huskyroboticsteam/Electronics-2017-18/README.md

# Electronics-2017-18

This is the 2017-18 Husky Robotics repository for electronics board designs and everything else electronics!
