huskyroboticsteam/Electronics-2017-18/EagleBoards/README.txt

Folder for the HRT Eagle library, Eagle Boards
