huskyroboticsteam/Electronics-2017-18/BrushedMotorBoard/BOM/BoM.xlsx

Manufacturer Part Number | Manufacturer | Digi-Key Part Number | Customer Reference | Reference Designator | Packaging | Part Status | Quantity | Unit Price | Extended Price | Quantity Available | Mfg Std Lead Time | Description | RoHS Status | Lead Free Status | REACH Status
STM32F334R8T6 | STMicroelectronics | 497-14955-ND |  |  | Tray | Active | 1 | 4.97 | $4.97 | 1897 | 10 Weeks | IC MCU 32BIT 64KB FLASH 64LQFP | RoHS Compliant | Lead free | Not Available
61300311121 | Wurth Electronics Inc. | 732-5316-ND |  |  | Bag | Active | 1 | 0.13 | $0.13 | 233027 | 14 Weeks | CONN HEADER 3 POS 2.54 | RoHS Compliant | Lead free | REACH Unaffected
SPC02SYAN | Sullins Connector Solutions | S9001-ND |  |  | Bulk | Active | 1 | 0.1 | $0.10 | 701455 | 4 Weeks | CONN JUMPER SHORTING GOLD FLASH | RoHS Compliant | Lead free | REACH Unaffected
ECS-110.5-S-4X | ECS Inc. | X1064-ND |  |  | Bulk | Active | 1 | 0.74 | $0.74 | 2156 | 9 Weeks | CRYSTAL 11.0592MHZ SERIES T/H | RoHS Compliant | Lead free | Not Available
RC1206JR-071M8L | Yageo | 311-1.8MERCT-ND |  |  | Cut Tape (CT) | Active | 1 | 0.1 | $0.10 | 0 | 29 Weeks | RES SMD 1.8M OHM 5% 1/4W 1206 | RoHS Compliant | Lead free | REACH Unaffected
CC1206JRNPO9BN180 | Yageo | 311-1152-1-ND |  |  | Cut Tape (CT) | Active | 2 | 0.3 | $0.60 | 34678 | 36 Weeks | CAP CER 18PF 50V C0G/NPO 1206 | RoHS Compliant | Lead free | REACH Unaffected
CC1206MRY5V9BB104 | Yageo | 311-4504-1-ND |  |  | Cut Tape (CT) | Active | 4 | 0.42 | $1.68 | 7894 | 36 Weeks | CAP CER 0.1UF 50V Y5V 1206 | RoHS Compliant | Lead free | REACH Unaffected
CC1206KKX7RCBB103 | Yageo | 311-1500-1-ND |  |  | Cut Tape (CT) | Active | 1 | 0.68 | $0.68 | 30000 | Not Available | CAP CER 10000PF 1KV X7R 1206 | RoHS Compliant | Lead free | REACH Unaffected
TXB0102DCUR | Texas Instruments | 296-22862-1-ND |  |  | Cut Tape (CT) | Active | 1 | 0.92 | $0.92 | 53958 | 12 Weeks | IC TRNSLTR BIDIRECTIONAL US8 | RoHS Compliant | Lead free | REACH Unaffected
ZX62D1-B-5PA(30) | Hirose Electric Co Ltd | H126316CT-ND |  |  | Cut Tape (CT) | Active | 2 | 0.77 | $1.54 | 3000 | 12 Weeks | CONN RCPT USB MICRO B 2.0 SMD RA | RoHS Compliant | Lead free | Not Available
0022232041 | Molex, LLC | WM4202-ND |  |  | Bulk | Active | 2 | 0.28 | $0.56 | 51523 | 7 Weeks | CONN HEADER 4POS .100 VERT TIN | RoHS Compliant | Lead free | REACH Unaffected
