huskyroboticsteam/Electronics-2017-18/Science/CAD Parts/MOLEX/MOLEX_22-23-2041.stl

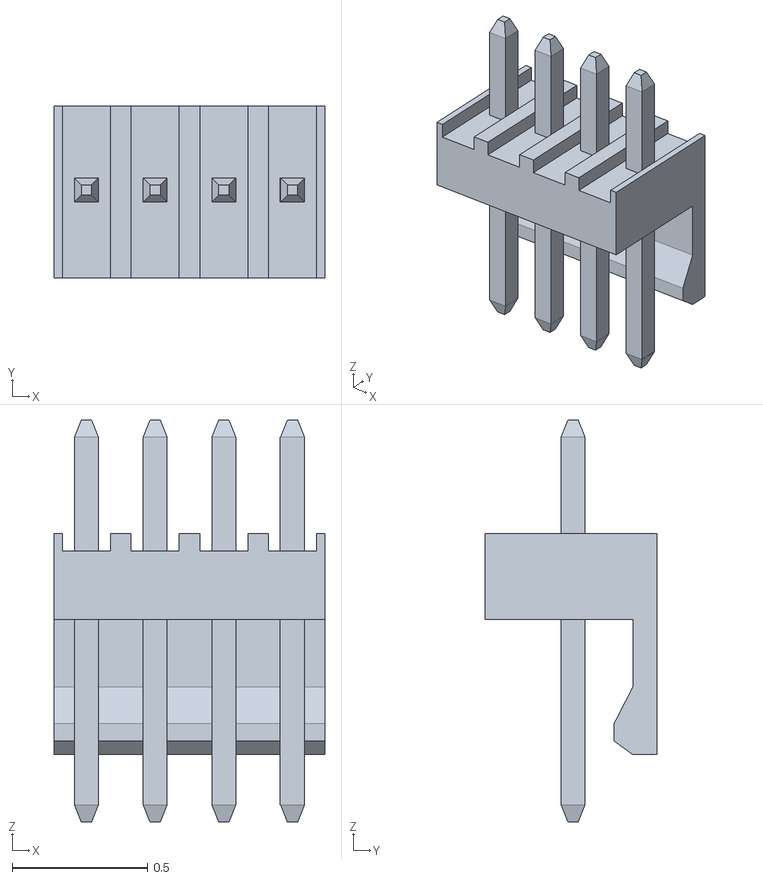
[picture p1: CAD file, 2018-01-22]
Science/CAD Parts/MOLEX/MOLEX_22-23-2041.stl
1.00 x 0.635 x 1.49
