huskyroboticsteam/Electronics-2017-18/Science/CAD Parts/PACKAGES/8SIOC.stp

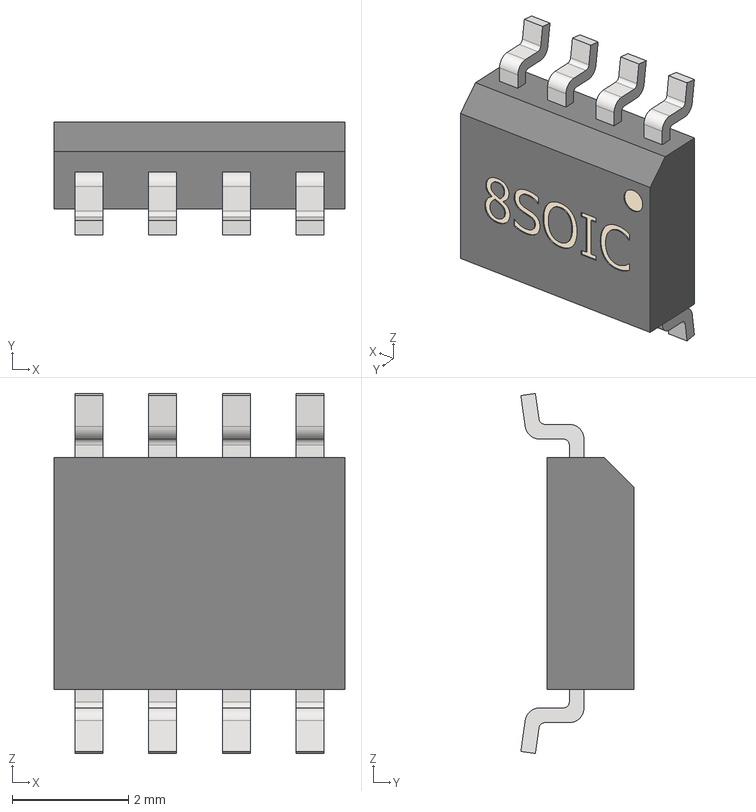
[picture p2: CAD file, 2018-01-22]
Science/CAD Parts/PACKAGES/8SIOC.stp
5.00 x 1.95 x 6.20 mm
8SOIC_BODY
8SOIC_PIN x 8
