huskyroboticsteam/Electronics-2017-18/Science/CAD Parts/MOLEX/MOLEX_22-23-2031.stl

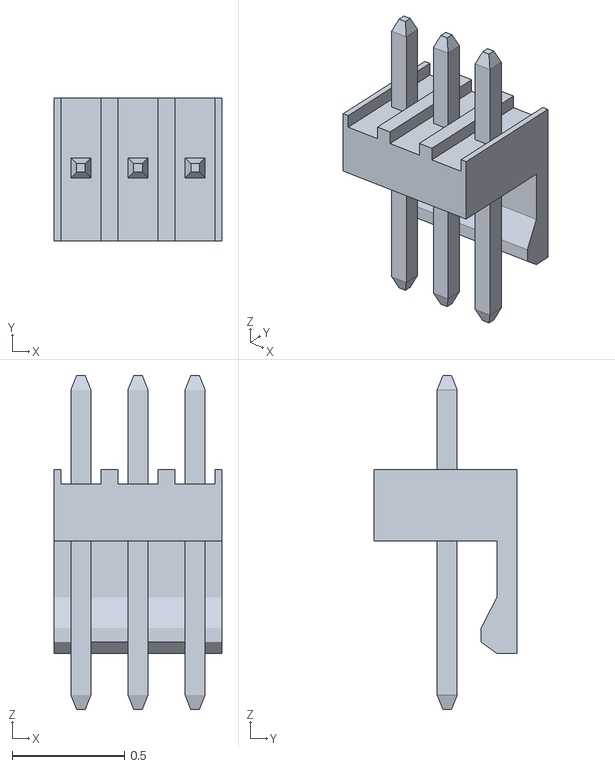
[picture p3: CAD file, 2018-01-22]
Science/CAD Parts/MOLEX/MOLEX_22-23-2031.stl
0.747 x 0.635 x 1.49
