huskyroboticsteam/Electronics-2017-18/BrushedMotorBoard/Models/022232041.stp

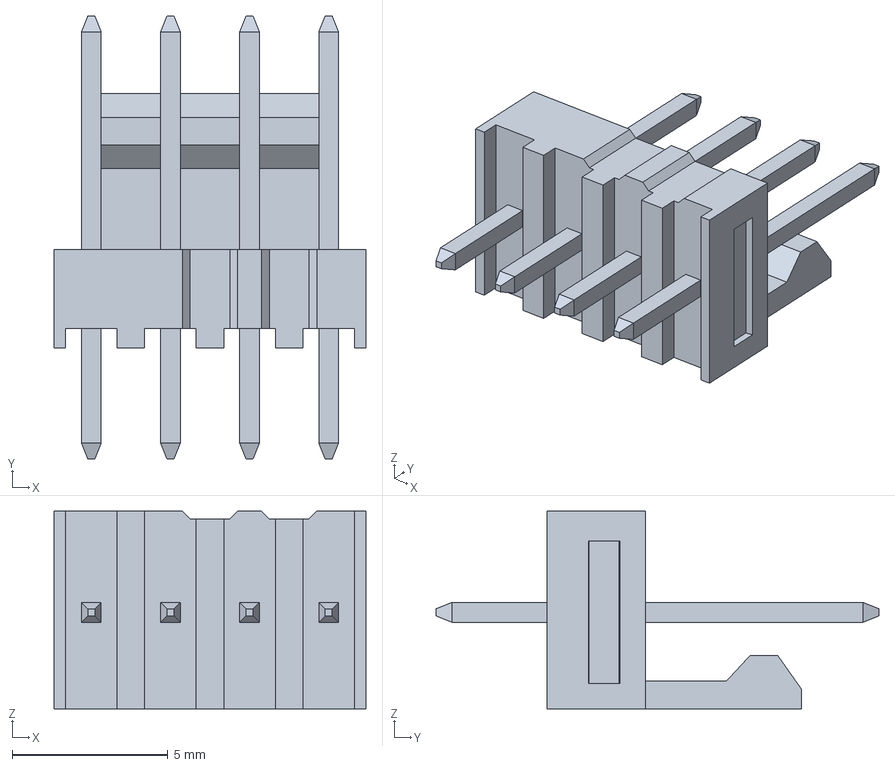
[picture p4: CAD file, 2018-10-06]
BrushedMotorBoard/Models/022232041.stp
10.0 x 14.2 x 6.35 mm
