huskyroboticsteam/Electronics-2017-18/(list of files, cad)

Other CAD files:
Science/CAD Parts/MOLEX/MOLEX_22-23-2031.ipt
Science/CAD Parts/MOLEX/MOLEX_22-23-2041.ipt
Science/CAD Parts/PACKAGES/8SIOC.iam
Science/CAD Parts/PACKAGES/8SIOC.stl
Science/CAD Parts/PACKAGES/8SOIC_BODY.ipt
Science/CAD Parts/PACKAGES/8SOIC_PIN.ipt
