huskyroboticsteam/Electronics-2017-18/(list of files, drawings)

Other design files:
BrushedMotorBoard/BrushedMotorBoard.PrjPcb
BrushedMotorBoard/HRTAltiumLib.SchLib
BrushedMotorBoard/HRTAltiumPcbLib.PcbLib
BrushedMotorBoard/Microcontroller.SchDoc
BrushedMotorBoard/Peripherals.SchDoc
BrushedMotorBoard/Power.SchDoc
