huskyroboticsteam/Electronics-2017-18/Science/Designs/Main Board/Main Board.kicad_pcb

## KiCad design Science/Designs/Main Board/Main Board.kicad_pcb (2018-01-23)

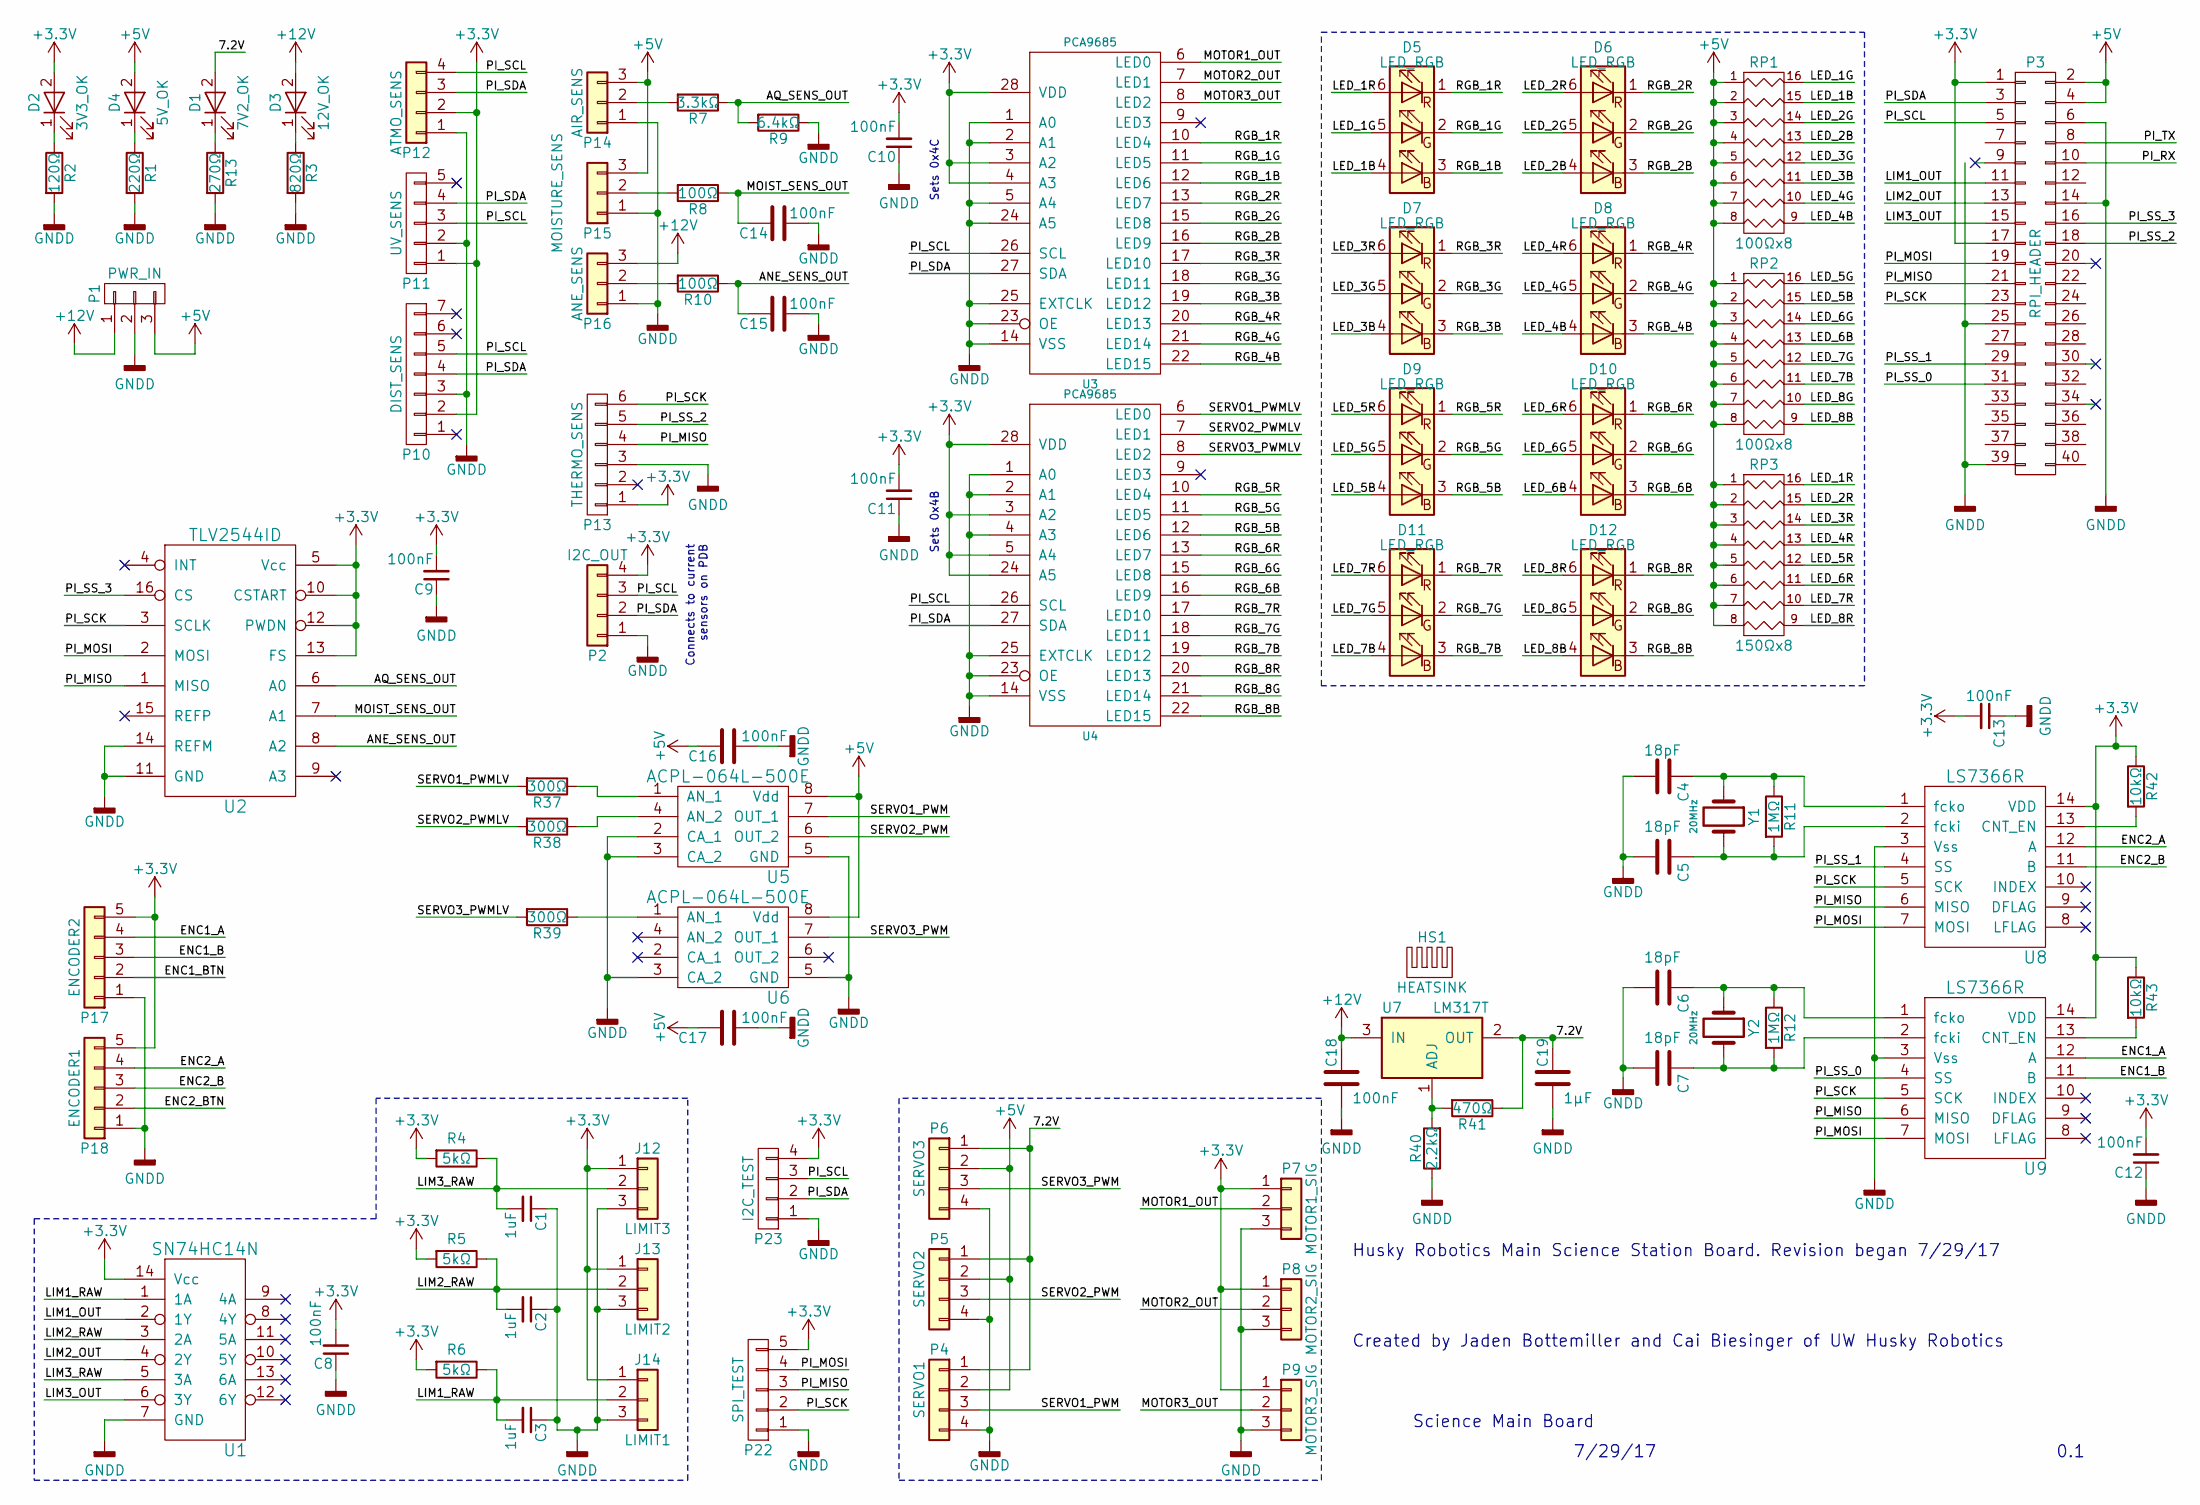
[picture p5: schematic Main Board.sch]

Parts:
C1, C2, C3: 1uF; C_1206_HandSoldering
C4, C5, C6, C7: 18pF; C_1206_HandSoldering
C8, C9, C10, C11, C12, C13, C14, C15, C16, C17, C18: 100nF; C_1206_HandSoldering
C19: 1µF; C_1206_HandSoldering
D1: 7V2_OK; LED_D5.0mm
D2: 3V3_OK; LED_D5.0mm
D3: 12V_OK; LED_D5.0mm
D4: 5V_OK; LED_D5.0mm
D5, D6, D7, D8, D9, D10, D11, D12: LED_RGB; SLV6A-FKB
HS1: HEATSINK; AAVID_531202B02500G
J12: LIMIT3; MOLEX_22-23-2031
J13: LIMIT2; MOLEX_22-23-2031
J14: LIMIT1; MOLEX_22-23-2031
P1: PWR_IN; PHOENIX_1792232
P2: I2C_OUT; MOLEX_22-23-2041
P3: RPI_HEADER; RPi-3B
P4: SERVO1; MOLEX_22-23-2041
P5: SERVO2; MOLEX_22-23-2041
P6: SERVO3; MOLEX_22-23-2041
P7: MOTOR1_SIG; MOLEX_22-23-2031
P8: MOTOR2_SIG; MOLEX_22-23-2031
P9: MOTOR3_SIG; MOLEX_22-23-2031
P10: DIST_SENS; MOLEX_22-23-2071
P11: UV_SENS; MOLEX_22-23-2051
P12: ATMO_SENS; MOLEX_22-23-2041
P13: THERMO_SENS; MOLEX_22-23-2061
P14: AIR_SENS; MOLEX_22-23-2031
P15: MOISTURE_SENS; MOLEX_22-23-2031
P16: ANE_SENS; MOLEX_22-23-2031
P17: ENCODER2; MOLEX_22-23-2051
P18: ENCODER1; MOLEX_22-23-2051
P22: SPI_TEST; Pin_Header_Straight_1x05_Pitch2.54mm
P23: I2C_TEST; Pin_Header_Straight_1x04_Pitch2.54mm
R1: 220Ω; R_1206_HandSoldering
R2: 120Ω; R_1206_HandSoldering
R3: 820Ω; R_1206_HandSoldering
R4, R5, R6: 5kΩ; R_1206_HandSoldering
R7: 3.3kΩ; R_1206_HandSoldering
R8, R10: 100Ω; R_1206_HandSoldering
R9: 6.4kΩ; R_1206_HandSoldering
R11, R12: 1MΩ; R_1206_HandSoldering
R13: 270Ω; R_1206_HandSoldering
R37, R38, R39: 300Ω; R_1206_HandSoldering
R40: 2.2kΩ; R_1206_HandSoldering
R41: 470Ω; R_1206_HandSoldering
R42, R43: 10kΩ; R_1206_HandSoldering
RP1, RP2: 100Ωx8; SOIC-16_3.9x9.9mm_Pitch1.27mm
RP3: 150Ωx8; SOIC-16_3.9x9.9mm_Pitch1.27mm
U1: SN74HC14N; SOIC-14_3.9x8.7mm_Pitch1.27mm
U2: TLV2544ID; SOIC-16_3.9x9.9mm_Pitch1.27mm
U3, U4: PCA9685; TSSOP-28_4.4x9.7mm_Pitch0.65mm
U5, U6: ACPL-064L-500E; SOIC-8_3.9x4.9mm_Pitch1.27mm
U7: LM317T; TO-220-3_Vertical
U8, U9: LS7366R; SOIC-14_3.9x8.7mm_Pitch1.27mm
Y1, Y2: 20MHz; HC-49USX

Connections:
+3V3: C8.2, C9.2, C10.2, C11.2, C12.2, C13.2, D2.2 (A), J12.1, J13.1, J14.1, P2.4, P3.1, P3.17, P7.1, P8.1, P9.1, P10.2, P11.1, P12.2, P13.1, P17.5, P18.5, P22.5, P23.4, R4.2, R5.2, R6.2, R42.1, R43.1, U1.14 (Vcc), U2.5 (Vcc), U2.10 (CSTART), U2.12 (PWDN), U2.13 (FS), U3.3 (A2), U3.4 (A3), U3.28 (VDD), U4.3 (A2), U4.5 (A4), U4.24 (A5), U4.28 (VDD), U8.14 (VDD), U9.14 (VDD)
+5V: C16.1, C17.1, D4.2 (A), P1.3, P3.2, P3.4, P4.2, P5.2, P6.2, P14.3, P15.3, RP1.1, RP1.2, RP1.3, RP1.4, RP1.5, RP1.6, RP1.7, RP1.8, RP2.1, RP2.2, RP2.3, RP2.4, RP2.5, RP2.6, RP2.7, RP2.8, RP3.1, RP3.2, RP3.3, RP3.4, RP3.5, RP3.6, RP3.7, RP3.8, U5.8 (Vdd), U6.8 (Vdd)
+12V: C18.1, D3.2 (A), P1.1, P16.3, U7.3 (IN)
/7.2V: C19.1, D1.2 (A), P4.1, P5.1, P6.1, R41.1, U7.2 (OUT)
/ANE_SENS_OUT: C15.2, R10.1, U2.8 (A2)
/AQ_SENS_OUT: R7.1, R9.2, U2.6 (A0)
/ENC1_A: P17.4, U9.12 (A)
/ENC1_B: P17.3, U9.11 (B)
/ENC1_BTN: P17.2
/ENC2_A: P18.4, U8.12 (A)
/ENC2_B: P18.3, U8.11 (B)
/ENC2_BTN: P18.2
/LED_1B: D5.4 (BA), RP1.15 (R2)
/LED_1G: D5.5 (GA), RP1.16 (R1)
/LED_1R: D5.6 (RA), RP3.16 (R1)
/LED_2B: D6.4 (BA), RP1.13 (R4)
/LED_2G: D6.5 (GA), RP1.14 (R3)
/LED_2R: D6.6 (RA), RP3.15 (R2)
/LED_3B: D7.4 (BA), RP1.11 (R6)
/LED_3G: D7.5 (GA), RP1.12 (R5)
/LED_3R: D7.6 (RA), RP3.14 (R3)
/LED_4B: D8.4 (BA), RP1.9 (R8)
/LED_4G: D8.5 (GA), RP1.10 (R7)
/LED_4R: D8.6 (RA), RP3.13 (R4)
/LED_5B: D9.4 (BA), RP2.15 (R2)
/LED_5G: D9.5 (GA), RP2.16 (R1)
/LED_5R: D9.6 (RA), RP3.12 (R5)
/LED_6B: D10.4 (BA), RP2.13 (R4)
/LED_6G: D10.5 (GA), RP2.14 (R3)
/LED_6R: D10.6 (RA), RP3.11 (R6)
/LED_7B: D11.4 (BA), RP2.11 (R6)
/LED_7G: D11.5 (GA), RP2.12 (R5)
/LED_7R: D11.6 (RA), RP3.10 (R7)
/LED_8B: D12.4 (BA), RP2.9 (R8)
/LED_8G: D12.5 (GA), RP2.10 (R7)
/LED_8R: D12.6 (RA), RP3.9 (R8)
/LIM1_OUT: P3.11, U1.2 (1Y)
/LIM1_RAW: C3.2, J14.2, R6.1, U1.1 (1A)
/LIM2_OUT: P3.13, U1.4 (2Y)
/LIM2_RAW: C2.2, J13.2, R5.1, U1.3 (2A)
/LIM3_OUT: P3.15, U1.6 (3Y)
/LIM3_RAW: C1.2, J12.2, R4.1, U1.5 (3A)
/MOIST_SENS_OUT: C14.2, R8.1, U2.7 (A1)
/MOTOR1_OUT: P7.2, U3.6 (LED0)
/MOTOR2_OUT: P8.2, U3.7 (LED1)
/MOTOR3_OUT: P9.2, U3.8 (LED2)
/PI_MISO: P3.21, P13.4, P22.3, U2.1 (MISO), U8.6 (MISO), U9.6 (MISO)
/PI_MOSI: P3.19, P22.4, U2.2 (MOSI), U8.7 (MOSI), U9.7 (MOSI)
/PI_RX: P3.10
/PI_SCK: P3.23, P13.6, P22.2, U2.3 (SCLK), U8.5 (SCK), U9.5 (SCK)
/PI_SCL: P2.3, P3.5, P10.5, P11.3, P12.4, P23.3, U3.26 (SCL), U4.26 (SCL)
/PI_SDA: P2.2, P3.3, P10.4, P11.4, P12.3, P23.2, U3.27 (SDA), U4.27 (SDA)
/PI_SS_0: P3.31, U9.4 (SS)
/PI_SS_1: P3.29, U8.4 (SS)
/PI_SS_2: P3.18, P13.5
/PI_SS_3: P3.16, U2.16 (CS)
/PI_TX: P3.8
/RGB_1B: D5.3 (BK), U3.12 (LED6)
/RGB_1G: D5.2 (GK), U3.11 (LED5)
/RGB_1R: D5.1 (RK), U3.10 (LED4)
/RGB_2B: D6.3 (BK), U3.16 (LED9)
/RGB_2G: D6.2 (GK), U3.15 (LED8)
/RGB_2R: D6.1 (RK), U3.13 (LED7)
/RGB_3B: D7.3 (BK), U3.19 (LED12)
/RGB_3G: D7.2 (GK), U3.18 (LED11)
/RGB_3R: D7.1 (RK), U3.17 (LED10)
/RGB_4B: D8.3 (BK), U3.22 (LED15)
/RGB_4G: D8.2 (GK), U3.21 (LED14)
/RGB_4R: D8.1 (RK), U3.20 (LED13)
/RGB_5B: D9.3 (BK), U4.12 (LED6)
/RGB_5G: D9.2 (GK), U4.11 (LED5)
/RGB_5R: D9.1 (RK), U4.10 (LED4)
/RGB_6B: D10.3 (BK), U4.16 (LED9)
/RGB_6G: D10.2 (GK), U4.15 (LED8)
/RGB_6R: D10.1 (RK), U4.13 (LED7)
/RGB_7B: D11.3 (BK), U4.19 (LED12)
/RGB_7G: D11.2 (GK), U4.18 (LED11)
/RGB_7R: D11.1 (RK), U4.17 (LED10)
/RGB_8B: D12.3 (BK), U4.22 (LED15)
/RGB_8G: D12.2 (GK), U4.21 (LED14)
/RGB_8R: D12.1 (RK), U4.20 (LED13)
/SERVO1_PWM: P4.3, U5.7 (OUT_1)
/SERVO1_PWMLV: R37.2, U4.6 (LED0)
/SERVO2_PWM: P5.3, U5.6 (OUT_2)
/SERVO2_PWMLV: R38.2, U4.7 (LED1)
/SERVO3_PWM: P6.3, U6.7 (OUT_1)
/SERVO3_PWMLV: R39.2, U4.8 (LED2)
GNDD: C1.1, C2.1, C3.1, C4.2, C5.2, C6.2, C7.2, C8.1, C9.1, C10.1, C11.1, C12.1, C13.1, C14.1, C15.1, C16.2, C17.2, C18.2, C19.2, J12.3, J13.3, J14.3, P1.2, P2.1, P3.6, P3.14, P3.25, P3.39, P4.4, P5.4, P6.4, P7.3, P8.3, P9.3, P10.3, P11.2, P12.1, P13.3, P14.1, P15.1, P16.1, P17.1, P18.1, P22.1, P23.1, R1.2, R2.2, R3.2, R9.1, R13.2, R40.1, U1.7 (GND), U2.11 (GND), U2.14 (REFM), U3.1 (A0), U3.2 (A1), U3.5 (A4), U3.14 (VSS), U3.23 (OE), U3.24 (A5), U3.25 (EXTCLK), U4.1 (A0), U4.2 (A1), U4.4 (A3), U4.14 (VSS), U4.23 (OE), U4.25 (EXTCLK), U5.2 (CA_1), U5.3 (CA_2), U5.5 (GND), U6.3 (CA_2), U6.5 (GND), U8.3 (Vss), U9.3 (Vss)
unnamed: C4.1, R11.1, U8.1 (fcko), Y1.1
unnamed: C5.1, R11.2, U8.2 (fcki), Y1.2
unnamed: C6.1, R12.1, U9.1 (fcko), Y2.1
unnamed: C7.1, R12.2, U9.2 (fcki), Y2.2
unnamed: D1.1 (K), R13.1
unnamed: D2.1 (K), R2.1
unnamed: D3.1 (K), R3.1
unnamed: D4.1 (K), R1.1
unnamed: P14.2, R7.2
unnamed: P15.2, R8.2
unnamed: P16.2, R10.2
unnamed: R37.1, U5.1 (AN_1)
unnamed: R38.1, U5.4 (AN_2)
unnamed: R39.1, U6.1 (AN_1)
unnamed: R40.2, R41.2, U7.1 (ADJ)
unnamed: R42.2, U8.13 (CNT_EN)
unnamed: R43.2, U9.13 (CNT_EN)

Notes on the sheet:
Husky Robotics Main Science Station Board. Revision began 7/29/17
Science Main Board
0.1
7/29/17
Created by Jaden Bottemiller and Cai Biesinger of UW Husky Robotics
Sets 0x4B
Sets 0x4C
Connects to current sensors on PDB

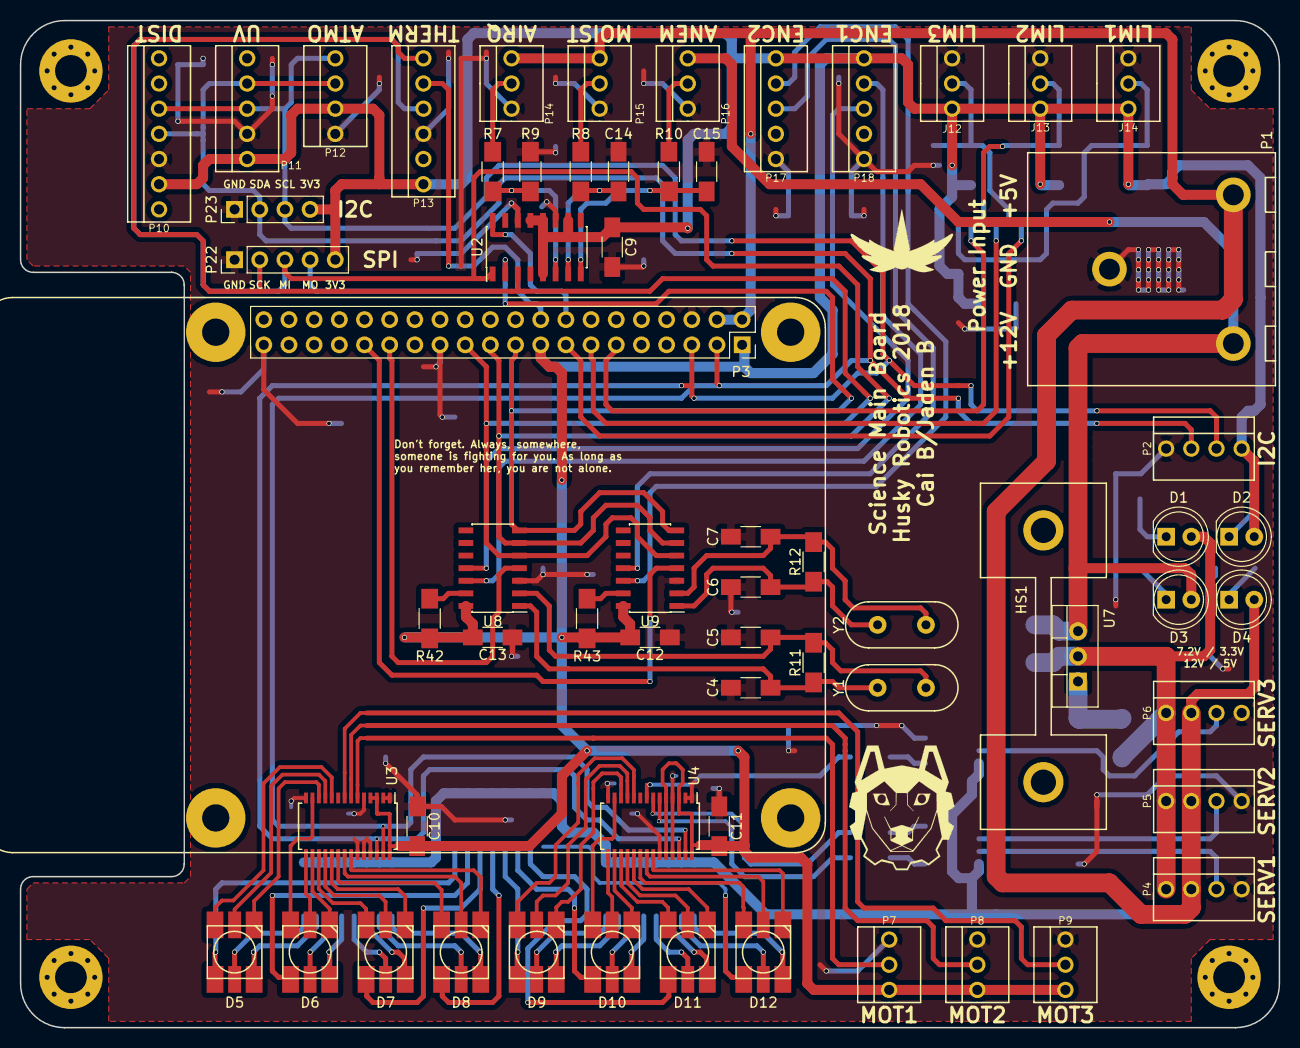
[picture p6: board Main Board.kicad_pcb from above]

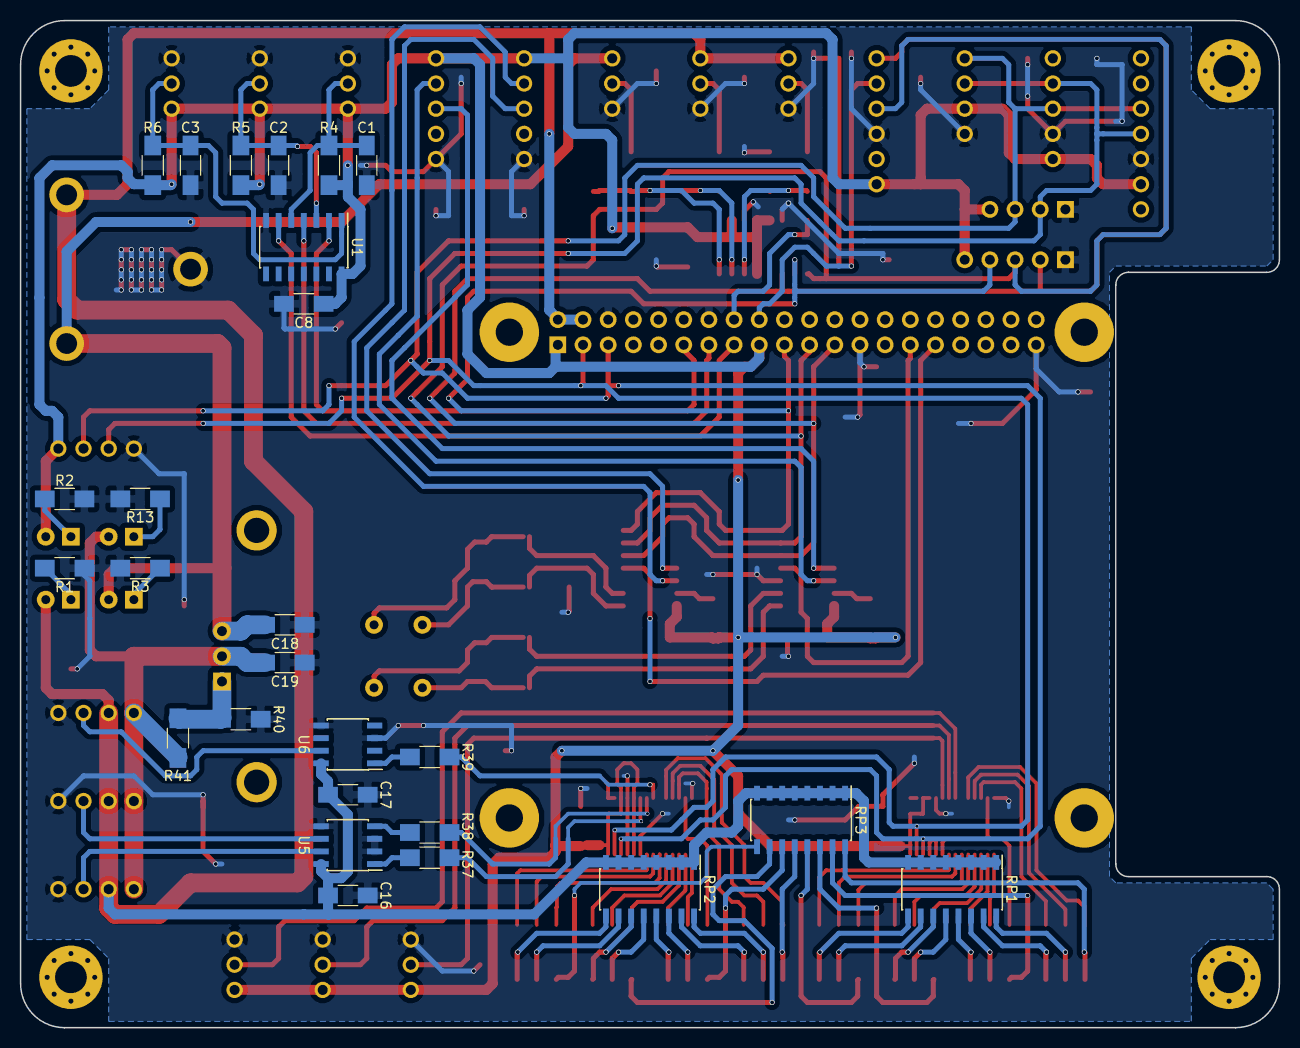
[picture p7: board Main Board.kicad_pcb from below]

Board: 2 copper layers, 127.0 x 101.6 mm, 89 parts (26 on the bottom side), 101 nets.
