huskyroboticsteam/Electronics-2017-18/Science/Designs/Power Board/Power Board.kicad_pcb

## KiCad design Science/Designs/Power Board/Power Board.kicad_pcb (2018-01-23)

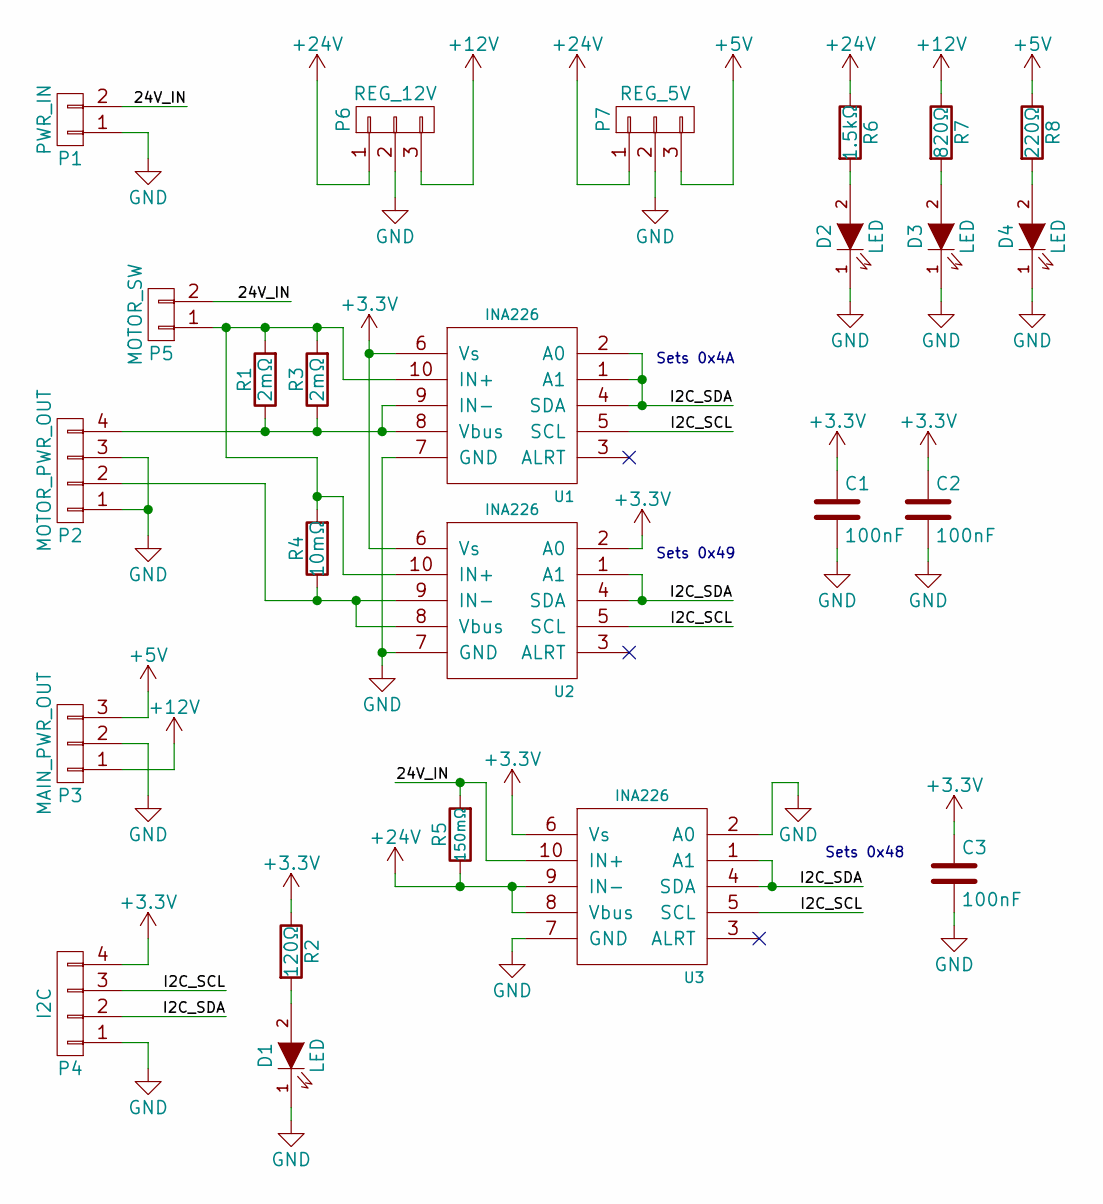
[picture p8: schematic Power Board.sch]

Parts:
C1, C2, C3: 100nF; C_1206_HandSoldering
D1, D2, D3, D4: LED; LED_D5.0mm
P1: PWR_IN; PHOENIX_1792229
P2: MOTOR_PWR_OUT; PHOENIX_1792245
P3: MAIN_PWR_OUT; PHOENIX_1792232
P4: I2C; MOLEX_22-23-2041
P5: MOTOR_SW; PHOENIX_1792229
P6: REG_12V; PHOENIX_1792232
P7: REG_5V; PHOENIX_1792232
R1, R3: 2mΩ; 2526W
R2: 120Ω; R_1206_HandSoldering
R4: 10mΩ; 2827W
R5: 150mΩ; R_Axial_Power_L25.0mm_W6.4mm_P30.48mm
R6: 1.5kΩ; R_1206_HandSoldering
R7: 820Ω; R_1206_HandSoldering
R8: 220Ω; R_1206_HandSoldering
U1, U2, U3: INA226; MSOP-10_3x3mm_Pitch0.5mm

Connections:
+3V3: C1.1, C2.1, C3.1, P4.4, R2.1, U1.6 (Vs), U2.2 (A0), U2.6 (Vs), U3.6 (Vs)
+5V: P3.3, P7.3, R8.1
+12V: P3.1, P6.3, R7.1
+24V: P6.1, P7.1, R5.1, R6.1, U3.8 (Vbus), U3.9 (IN-)
/24V_IN: P1.2, P5.2, R5.2, U3.10 (IN+)
/I2C_SCL: P4.3, U1.5 (SCL), U2.5 (SCL), U3.5 (SCL)
/I2C_SDA: P4.2, U1.1 (A1), U1.2 (A0), U1.4 (SDA), U2.1 (A1), U2.4 (SDA), U3.1 (A1), U3.4 (SDA)
GND: C1.2, C2.2, C3.2, D1.1 (K), D2.1 (K), D3.1 (K), D4.1 (K), P1.1, P2.1, P2.3, P3.2, P4.1, P6.2, P7.2, U1.7 (GND), U2.7 (GND), U3.2 (A0), U3.7 (GND)
unnamed: D1.2 (A), R2.2
unnamed: D2.2 (A), R6.2
unnamed: D3.2 (A), R7.2
unnamed: D4.2 (A), R8.2
unnamed: P2.2, R4.1, U2.8 (Vbus), U2.9 (IN-)
unnamed: P2.4, R1.1, R3.1, U1.8 (Vbus), U1.9 (IN-)
unnamed: P5.1, R1.2, R3.2, R4.2, U1.10 (IN+), U2.10 (IN+)

Notes on the sheet:
Sets 0x4A
Sets 0x49
Sets 0x48

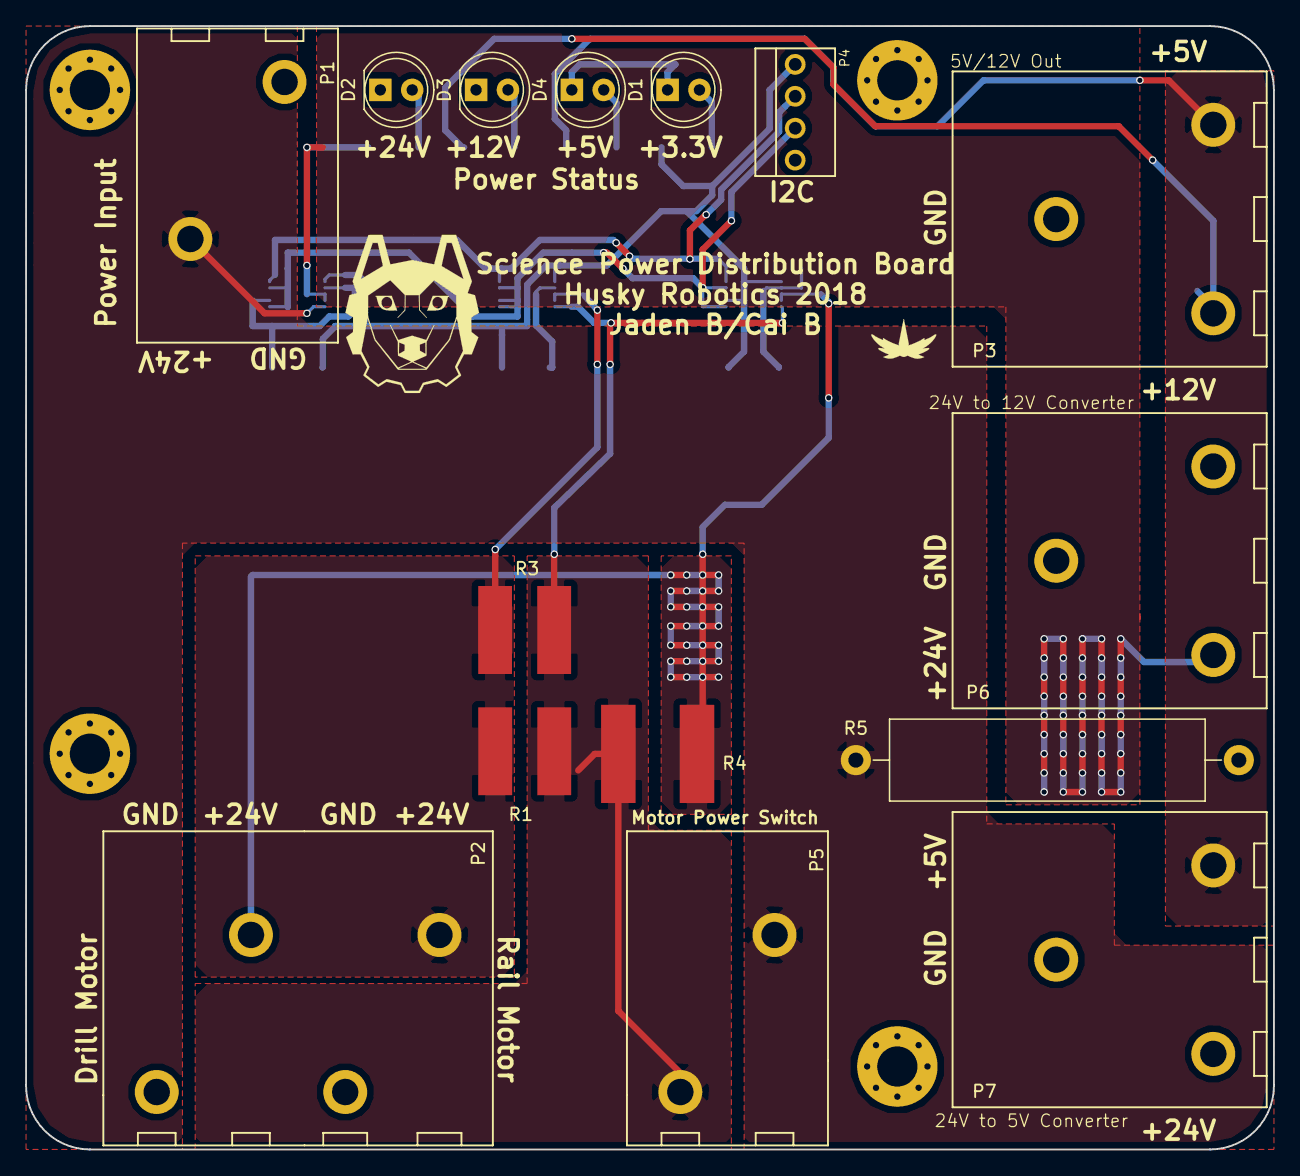
[picture p9: board Power Board.kicad_pcb from above]

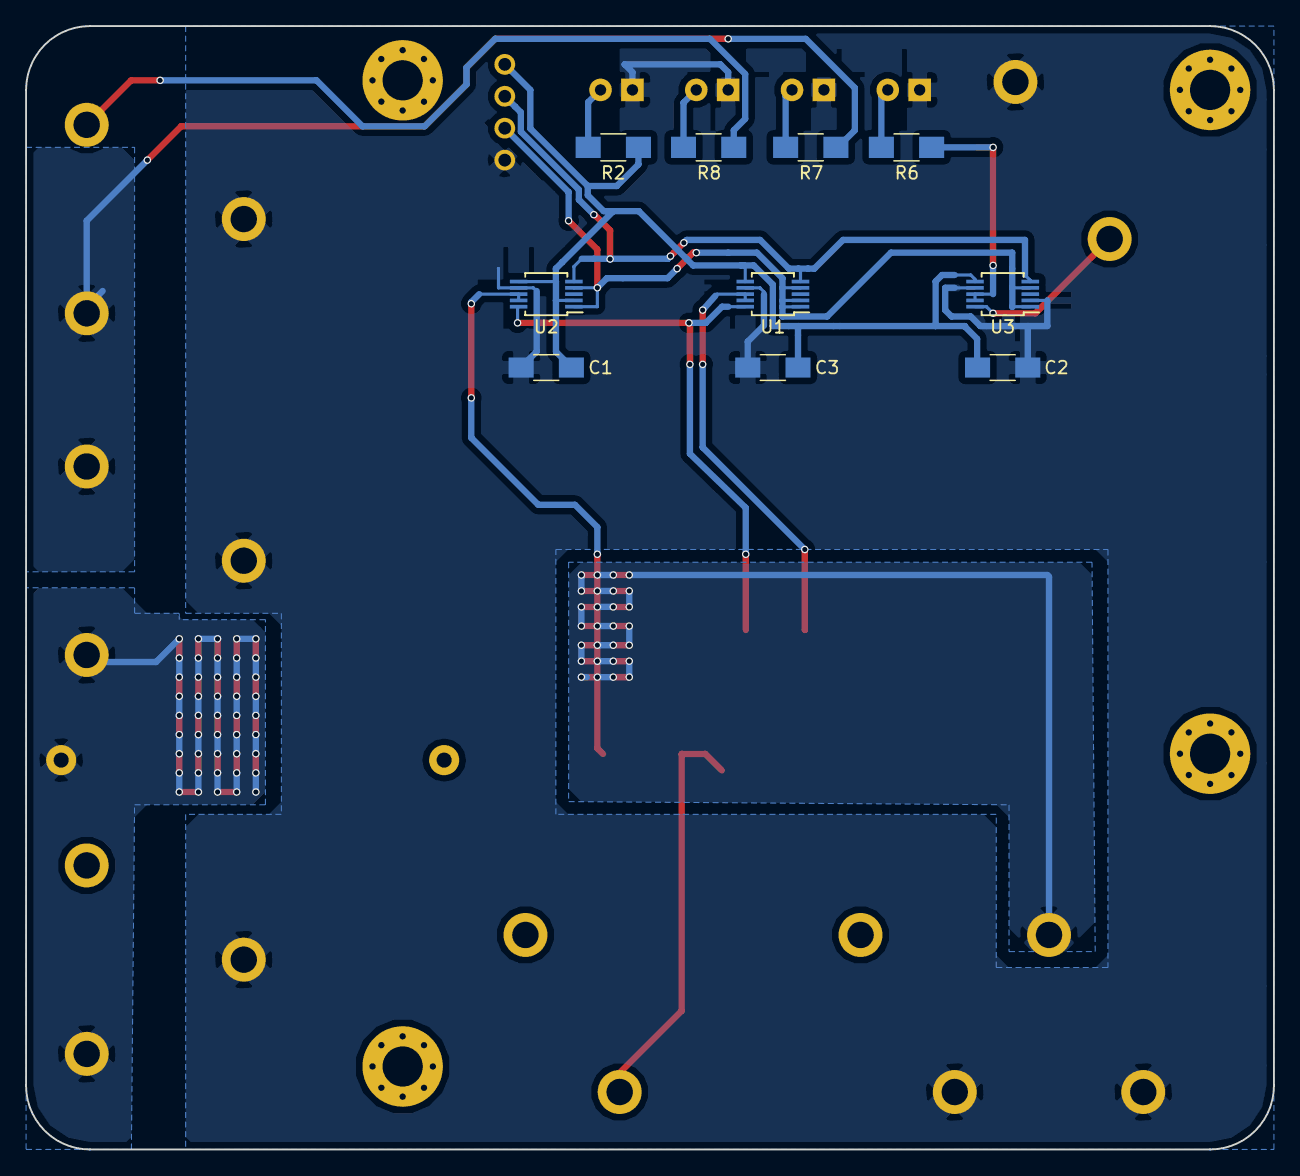
[picture p10: board Power Board.kicad_pcb from below]

Board: 2 copper layers, 99.3 x 89.4 mm, 25 parts (10 on the bottom side), 15 nets.
