huskyroboticsteam/Electronics-2017-18/EagleBoards/Arm/encoder counter double/encoder counter double.brd

## EAGLE design EagleBoards/Arm/encoder counter double/encoder counter double.brd (2018-07-21)

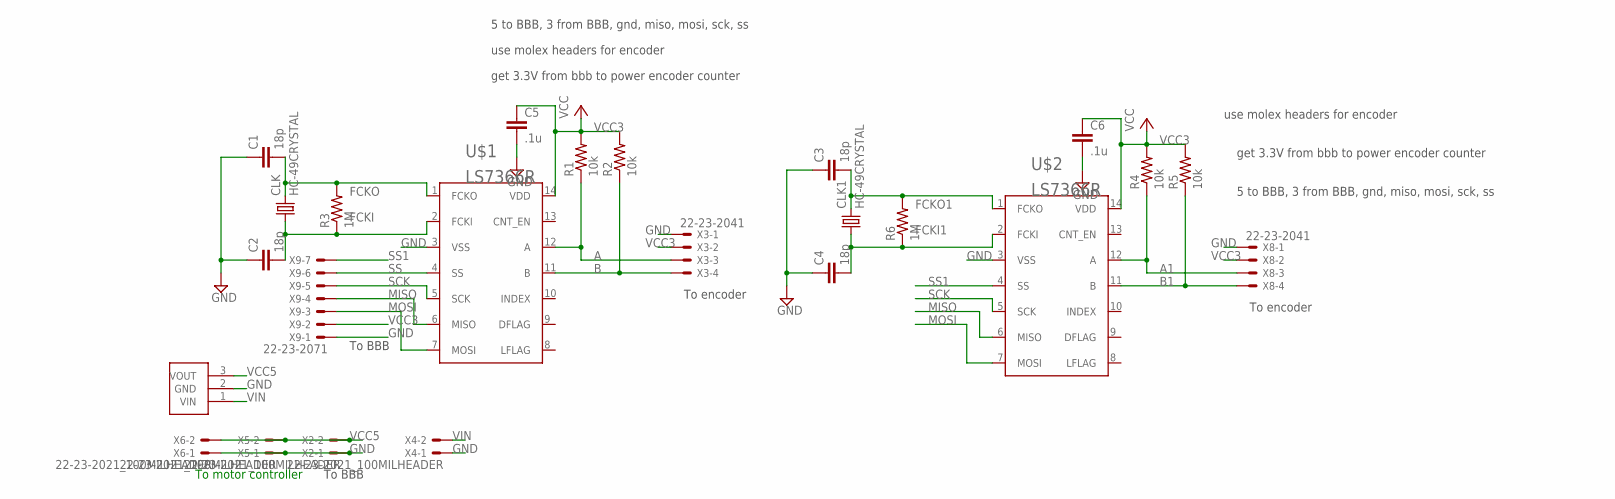
[picture p11: schematic encoder counter double.sch]

Parts:
C1, C2, C3, C4: 18p; C1206
C5, C6: .1u; C1206
CLK, CLK1: HC-49CRYSTAL; HC49/S
R1, R2, R4, R5: 10k; R1206
R3, R6: 1M; R1206
U$1, U$2: LS7366R; SO14
U$3: OKI-78SR-X_3PIN-DCDC; MA03-1
X2, X4, X5, X6: 22-23-2021_100MILHEADER; 22-23-2021_199MILHEADER
X3, X8: 22-23-2041
X9: 22-23-2071

Connections:
A: R1.1, U$1.12 (A), X3.3
A1: R4.1, U$2.12 (A), X8.3
B: R2.1, U$1.11 (B), X3.4
B1: R5.1, U$2.11 (B), X8.4
FCKI: C2.2, CLK.1, R3.1, U$1.2 (FCKI)
FCKI1: C4.2, CLK1.1, R6.1, U$2.2 (FCKI)
FCKO: C1.2, CLK.2, R3.2, U$1.1 (FCKO)
FCKO1: C3.2, CLK1.2, R6.2, U$2.1 (FCKO)
GND: C1.1, C2.1, C3.1, C4.1, C5.2, C6.2, U$1.3 (VSS), U$2.3 (VSS), U$3.2 (GND), X2.1, X3.1, X4.1, X5.1, X6.1, X8.1, X9.1
MISO: U$1.6 (MISO), U$2.6 (MISO), X9.4
MOSI: U$1.7 (MOSI), U$2.7 (MOSI), X9.3
SCK: U$1.5 (SCK), U$2.5 (SCK), X9.5
SS: U$1.4 (SS), X9.6
SS1: U$2.4 (SS), X9.7
VCC3: C5.1, C6.1, R1.2, R2.2, R4.2, R5.2, U$1.14 (VDD), U$2.14 (VDD), X3.2, X8.2, X9.2
VCC5: U$3.3 (VOUT), X2.2, X5.2, X6.2
VIN: U$3.1 (VIN), X4.2

Notes on the sheet:
use molex headers for encoder
get 3.3V from bbb to power encoder counter
5 to BBB, 3 from BBB, gnd, miso, mosi, sck, ss
To BBB
To encoder
To motor controller

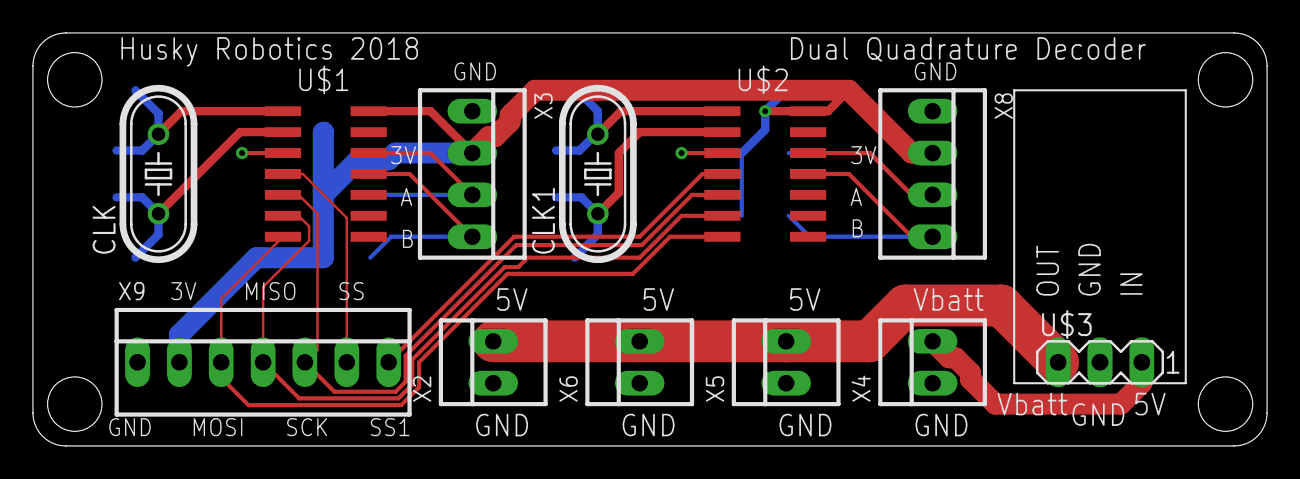
[picture p12: board encoder counter double.brd from above]

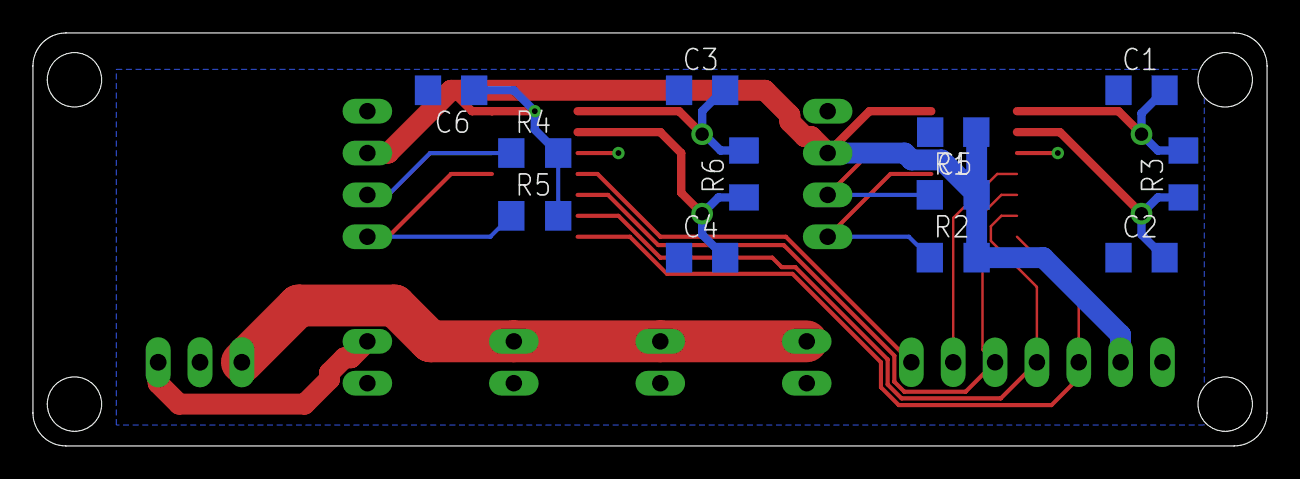
[picture p13: board encoder counter double.brd from below]

Board: 2 copper layers, 74.9 x 25.1 mm, 24 parts (12 on the bottom side), 17 nets.
