huskyroboticsteam/Electronics-2017-18/EagleBoards/Chassis/HRT PDB 17-18/HRT PDB 17-18 schem.brd

## EAGLE design EagleBoards/Chassis/HRT PDB 17-18/HRT PDB 17-18 schem.brd (2017-12-23)

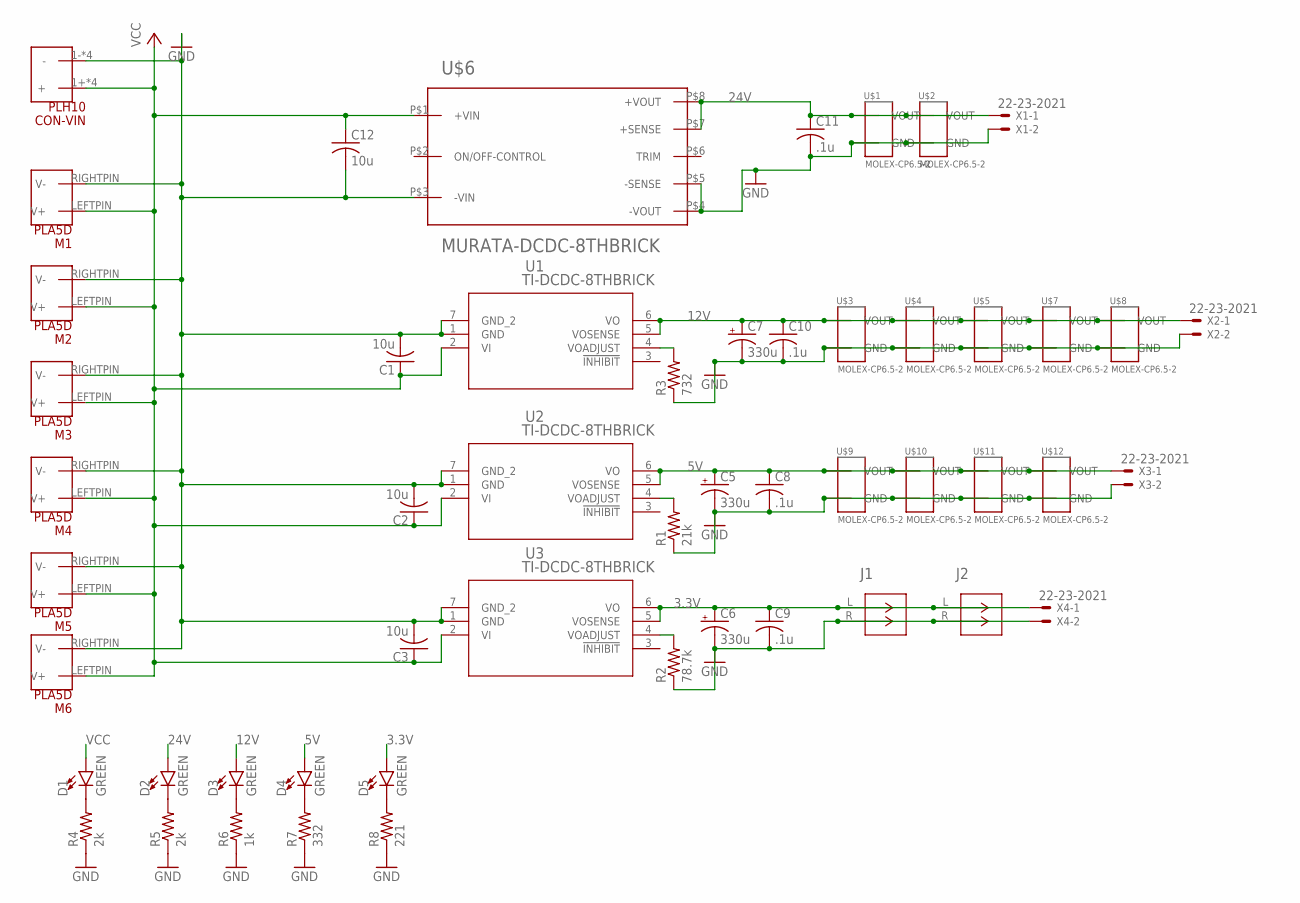
[picture p14: schematic HRT PDB 17-18 schem.sch]

Parts:
C1, C2, C3, C12: 10u; C1210
C5, C6, C7: 330u; E5-10,5
C8, C9, C10, C11: .1u; C0603
CON-VIN: PLH10; PLH10PCKG
D1, D2, D3, D4, D5: GREEN; LED-0603
J1, J2: TE-TERM-BLOCK
M1, M2, M3, M4, M5, M6: PLA5D; PLA5PACK
R1: 21k; R0603
R2: 78.7k; R0603
R3: 732; R0603
R4, R5: 2k; R0805
R6: 1k; R0805
R7: 332; R0805
R8: 221; R0805
U1, U2, U3: TI-DCDC-8THBRICK; TIBRICK
U$1, U$2, U$3, U$4, U$5, U$7, U$8, U$9, U$10, U$11, U$12: MOLEX-CP6.5-2; 151048-X2XX
U$6: MURATA-DCDC-8THBRICK; MURATA-8THBRICK
X1, X2, X3, X4: 22-23-2021

Connections:
3.3V: C6.+, C9.1, D5.A, J1.L (1), J2.L (1), U3.5 (VOSENSE), U3.6 (VO), X4.1
5V: C5.+, C8.1, D4.A, U2.5 (VOSENSE), U2.6 (VO), U$9.VOUT, U$10.VOUT, U$11.VOUT, U$12.VOUT, X3.1
12V: C7.+, C10.1, D3.A, U1.5 (VOSENSE), U1.6 (VO), U$3.VOUT, U$4.VOUT, U$5.VOUT, U$7.VOUT, U$8.VOUT, X2.1
24V: C11.1, D2.A, U$1.VOUT, U$2.VOUT, U$6.P$7 (+SENSE), U$6.P$8 (+VOUT), X1.1
GND: C1.2, C2.2, C3.2, C5.-, C6.-, C7.-, C8.2, C9.2, C10.2, C11.2, C12.2, CON-VIN.1- (-), CON-VIN.2- (-), CON-VIN.3- (-), CON-VIN.4- (-), J1.R (2), J2.R (2), M1.RIGHTPIN (V-), M2.RIGHTPIN (V-), M3.RIGHTPIN (V-), M4.RIGHTPIN (V-), M5.RIGHTPIN (V-), M6.RIGHTPIN (V-), R1.1, R2.1, R3.1, R4.1, R5.1, R6.1, R7.1, R8.1, U1.1 (GND), U1.7 (GND_2), U2.1 (GND), U2.7 (GND_2), U3.1 (GND), U3.7 (GND_2), U$1.GND, U$2.GND, U$3.GND, U$4.GND, U$5.GND, U$6.P$3 (-VIN), U$6.P$4 (-VOUT), U$6.P$5 (-SENSE), U$7.GND, U$8.GND, U$9.GND, U$10.GND, U$11.GND, U$12.GND, X1.2, X2.2, X3.2, X4.2
unnamed: D1.C, R4.2
unnamed: D2.C, R5.2
unnamed: R2.2, U3.4 (VOADJUST)
unnamed: R3.2, U1.4 (VOADJUST)
unnamed: R1.2, U2.4 (VOADJUST)
unnamed: D3.C, R6.2
unnamed: D4.C, R7.2
unnamed: D5.C, R8.2
VCC: C1.1, C2.1, C3.1, C12.1, CON-VIN.1+ (+), CON-VIN.2+ (+), CON-VIN.3+ (+), CON-VIN.4+ (+), D1.A, M1.LEFTPIN (V+), M2.LEFTPIN (V+), M3.LEFTPIN (V+), M4.LEFTPIN (V+), M5.LEFTPIN (V+), M6.LEFTPIN (V+), U1.2 (VI), U2.2 (VI), U3.2 (VI), U$6.P$1 (+VIN)

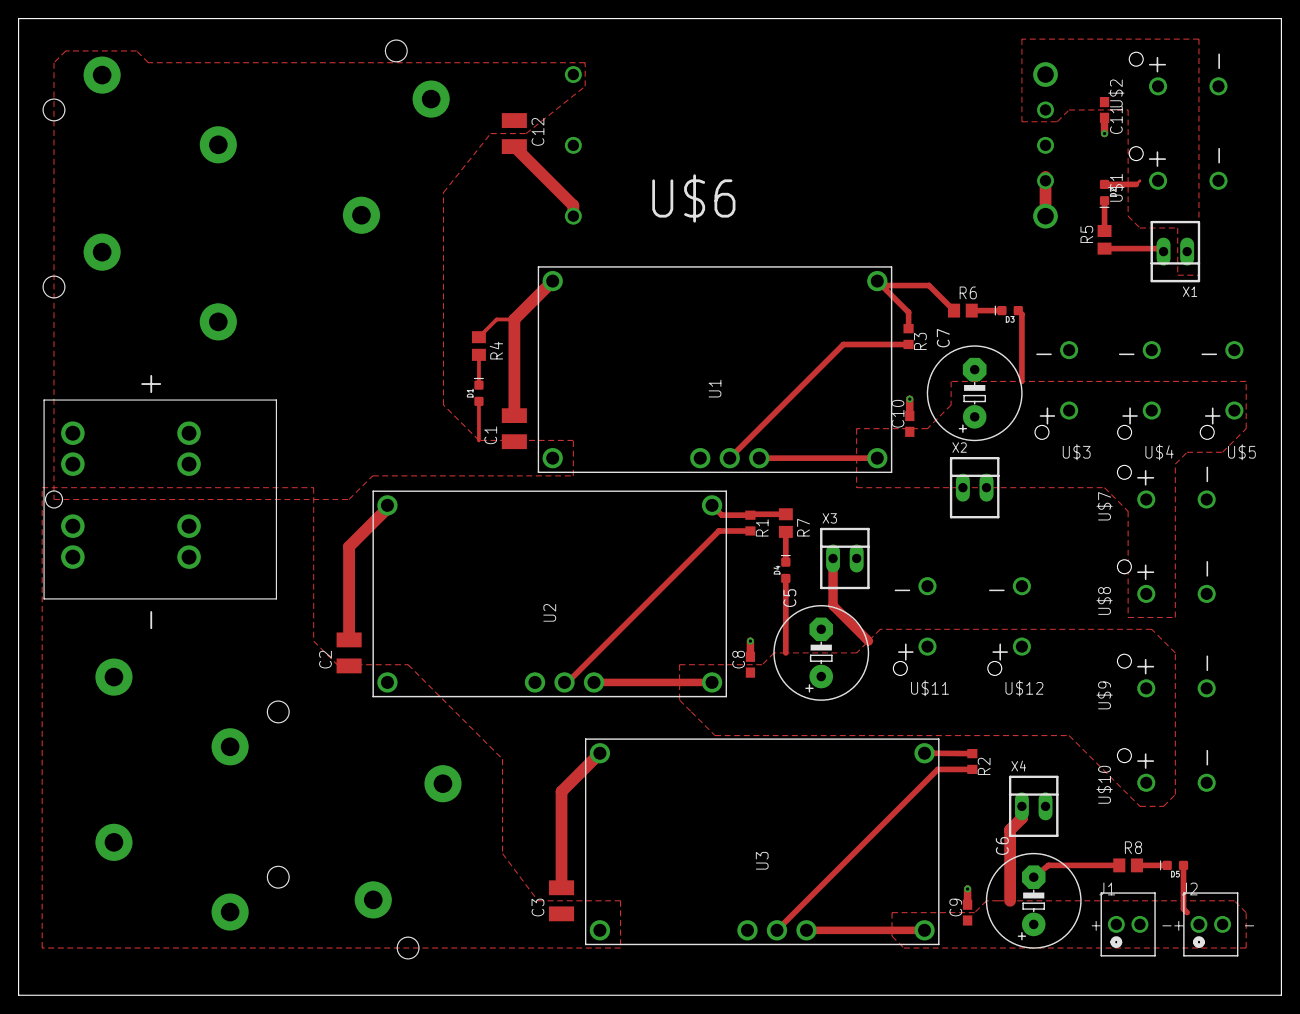
[picture p15: board HRT PDB 17-18 schem.brd from above]

Board: 2 copper layers, 135.9 x 105.1 mm, 52 parts (0 on the bottom side), 14 nets.
