huskyroboticsteam/Electronics-2017-18/(commit log)

2017-12-02 Added existing Science designs.
    [Main Board.kicad_pcb, Main Board.sch, Power Board.kicad_pcb, Power Board.sch]
2017-12-02 Added Servo outputs
    Removed Encoder debouncing
    [_saved_Main Board.sch]
2017-12-02 Actually saved this time
    [Main Board.sch, _saved_Main Board.sch]
2017-12-02 Merged KiCad Libraries
    Now we have one "sciencelib" instead of 3. Releavnt changes made in schematics.
    [Main Board.sch]
2017-12-02 Changed labelling standard for main board
    [Main Board.sch]
2017-12-02 Current sensing on power board
    [Power Board.sch]
2017-12-05 Added power pinouts and servo connections
    [Main Board.sch]
2017-12-09 Changed LS7366R implementation per spec
    [Main Board.sch]
2017-12-23 chassis PDB in layout
    [Power conversion board.brd, Power conversion board.sch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]
2017-12-23 PDB mid dev
    [HRT PDB 17-18 schem.brd, HRT PDB 17-18 schem.sch, Power conversion board.brd, Power conversion board.sch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]
2017-12-23 pdb rev a
    [HRT PDB 17-18 schem.brd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]
2018-01-07 Added sensor connections
    [Main Board.sch]
2018-01-07 Added ADC to main board schematic
    [Main Board.sch]
2018-01-07 Updated schematic with new ADC layout
    [_saved_Main Board.sch]
2018-01-07 Aded PWM device to schematic
    [Main Board.sch, _saved_Main Board.sch]
2018-01-10 Adding component values, system current sensor
    [Power Board.sch]
2018-01-12 Added decoupling capacitors, started component associatons, added RGB LEDs
    [Main Board.sch]
2018-01-12 Cleaning up schematic, adding I2C test connector
    [Main Board.sch]
2018-01-13 Fixing various board issues
    Decoupling caps, power connector, sensor connectors, power LEDs, etc.
    [Main Board.sch]
2018-01-13 Added cable connector datasheets
2018-01-13 Fixed issues
    [Main Board.sch, Power Board.sch]
2018-01-13 Added missing pullup
    [Main Board.sch]
2018-01-13 Added optocouplers to servo outputs
    [Main Board.sch]
2018-01-13 Fixed optocoupler
    [Main Board.sch]
2018-01-13 Added connectors
2018-01-13 Added 7.2V regulator
    [Main Board.sch]
2018-01-13 Schematic cleanup
    [Main Board.sch]
2018-01-13 Switched to resistor networks for RGB LEDs
    [Main Board.sch]
2018-01-13 Began Main board layout
    [_saved_Main Board.sch]
2018-01-13 Continued working on main PCB
    [Main Board.kicad_pcb, Main Board.sch, _saved_Main Board.sch]
2018-01-14 Added BAC connectors to library
    [Main Board.kicad_pcb]
2018-01-14 Added RPi and Crystal Footprints
    [_saved_Main Board.sch]
2018-01-14 Fixed RPi Footprint
    Someone (me) got the outline flipped...
    [Main Board.kicad_pcb]
2018-01-14 Added RGB LED footprint, working on layout
    [Main Board.kicad_pcb, _saved_Main Board.sch]
2018-01-14 Working on PCB
    [Main Board.kicad_pcb, Main Board.sch, _saved_Main Board.sch]
2018-01-14 Continuing PCB some more
    [Main Board.kicad_pcb]
2018-01-14 Began Power Board layout
    [Power Board.sch, _saved_Power Board.sch]
2018-01-14 Added heatsink footprint
2018-01-14 Continued continuing on main board
    [Main Board.kicad_pcb, _saved_Main Board.sch]
2018-01-14 Updated footprint library
    [Power Board.kicad_pcb, _saved_Power Board.sch]
2018-01-14 "Finished routing"
    Except not really because it sucks
    [Power Board.kicad_pcb]
2018-01-14 Final PDB changes for tonight
    [Power Board.kicad_pcb]
2018-01-14 Last schematic changes for the night
    [Power Board.sch, _saved_Power Board.sch]
2018-01-14 Finishing up for tonight.
    [Main Board.kicad_pcb, Main Board.sch, _saved_Main Board.sch]
2018-01-14 Changed layout again
    Could definitely still use some work...
    [Power Board.kicad_pcb]
2018-01-14 Finished way better layout
    [Power Board.kicad_pcb]
2018-01-14 Removed uneccessary vias
    [Power Board.kicad_pcb]
2018-01-14 Edited silkscreen
2018-01-14 Added CAD files for 3-PIN molex connector
    [MOLEX_22-23-2031.ipt, MOLEX_22-23-2031.stl, Power Board.kicad_pcb]
2018-01-15 Added 4-PIN MOLEX CAD
    [MOLEX_22-23-2041.ipt, MOLEX_22-23-2041.stl]
2018-01-15 More layout
    [Main Board.kicad_pcb]
2018-01-15 Updated footprints
    [8SIOC.iam, 8SIOC.stl, 8SIOC.stp, 8SOIC_BODY.ipt, 8SOIC_PIN.ipt, MOLEX_22-23-2031.ipt, MOLEX_22-23-2031.stl, MOLEX_22-23-2041.ipt]
2018-01-15 Even more layout
    [Main Board.kicad_pcb]
2018-01-15 Added mounting holes
    [Power Board.kicad_pcb]
2018-01-15 Done for the nigtht.
    Good progress!
    [Power Board.kicad_pcb]
2018-01-15 Layout nearing completion.
    [Main Board.kicad_pcb, Main Board.sch]
2018-01-17 Small track updates
    [Power Board.kicad_pcb]
2018-01-20 Continued work on main board layout. Nearing completion!
    [Main Board.kicad_pcb]
2018-01-20 Continuing layout work
    [Main Board.kicad_pcb]
2018-01-20 Almost done
    [Power Board.kicad_pcb]
2018-01-21 Very close to finished main board
    Just needs ground plane work now!
    [Main Board.kicad_pcb, Main Board.sch]
2018-01-21 Redesign started. Looks better, although still has issues
    [Power Board.kicad_pcb]
2018-01-21 Ground planes almost done
    [Main Board.kicad_pcb]
2018-01-21 All connections made
    I think I am within spec as much as I can be. Maybe we should go with 2oz copper on this board
    [Power Board.kicad_pcb]
2018-01-21 Fixed polygon combination
    [Power Board.kicad_pcb]
2018-01-21 Last trace changes
    Will work on solder mask now
    [Power Board.kicad_pcb]
2018-01-21 Stripped away soldermask on front and back
    [Power Board.kicad_pcb]
2018-01-21 Main Board finished?
    [Main Board.kicad_pcb, Main Board.sch]
2018-01-21 Fixing issues, adding logos
    [Main Board.kicad_pcb]
2018-01-22 Fixed polygons
    [Power Board.kicad_pcb]
2018-01-22 I think the Science PDB is done
    [Power Board.kicad_pcb]
2018-01-22 Added I2C label
    (Spoke too soon)
    [Power Board.kicad_pcb]
2018-01-22 Moved a few component designators
    [Power Board.kicad_pcb]
2018-01-22 Final changes
    (I didn't save apparently)
    [Power Board.kicad_pcb]
2018-01-22 Replaced current sensor with INA226
    [Power Board.kicad_pcb, _saved_Power Board.sch]
2018-01-22 Forgot to save schematic changes
    [Power Board.sch, _saved_Power Board.sch]
2018-01-23 Added Labels
    PDB is officially done
    [Power Board.kicad_pcb]
2018-01-23 Last-minute changes and production output for main board
    [Main Board-B.Cu.gbr, Main Board-B.Mask.gbr, Main Board-B.SilkS.gbr, Main Board-Edge.Cuts.gbr, Main Board-F.Cu.gbr, Main Board-F.Mask.gbr, Main Board-F.SilkS.gbr, Main Board.drl]
2018-01-23 PDB production output
    [Power Board-B.Cu.gbr, Power Board-B.Mask.gbr, Power Board-B.SilkS.gbr, Power Board-Edge.Cuts.gbr, Power Board-F.Cu.gbr, Power Board-F.Mask.gbr, Power Board-F.SilkS.gbr, Power Board.drl]
2018-04-15 Fixing address error
    [Main Board.sch]
2018-06-11 encoder counter brd in layout
    [encoder counter.brd, encoder counter.sch]
2018-06-29 pre silk encoder brds. layout ready for review
    [encoder counter double.brd, encoder counter double.sch]
2018-07-02 encoder boards done
    [encoder counter double.brd, encoder counter double.sch, encoder counter.brd]
2018-07-21 printed designs with gerbers
    [encoder counter double.brd, encoder counter double.sch, encoder counter.brd, encoder counter.sch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]
2018-10-05 Added new board (in prog)
    [BoM.xlsx, BrushedMotorBoard.PrjPcb, HRTAltiumLib.SchLib, HRTAltiumPcbLib.PcbLib, Microcontroller.SchDoc, Peripherals.SchDoc, Power.SchDoc]
2018-10-05 Added UART/USB, JTAG, I2C outputs for programming
    [BoM.xlsx, HRTAltiumLib.SchLib, Microcontroller.SchDoc, Peripherals.SchDoc]
2018-10-05 Changed components
    [BrushedMotorBoard.PrjPcb, HRTAltiumLib.SchLib, Microcontroller.SchDoc, Peripherals.SchDoc, Power.SchDoc]
2018-10-06 Spent more time on models than I would have like to
    [BrushedMotorBoard.PrjPcb, HRTAltiumLib.SchLib, HRTAltiumPcbLib.PcbLib, Microcontroller.SchDoc, Peripherals.SchDoc, Power.SchDoc]
2018-10-06 Actually added the model to the part...
    [HRTAltiumLib.SchLib, Peripherals.SchDoc]
2018-10-06 Saving projects isn't completely intiuitive to me yet
    [022232041.stp]
2018-10-06 Continuing work
    [Microcontroller.SchDoc, Peripherals.SchDoc]
2018-10-08 Worked on power for a bit
    [HRTAltiumLib.SchLib, Microcontroller.SchDoc, Peripherals.SchDoc, Power.SchDoc]
